dkjonas/WildWillyR5Hardware/README.md

Schematic and board layout for the R5 version of my robot.

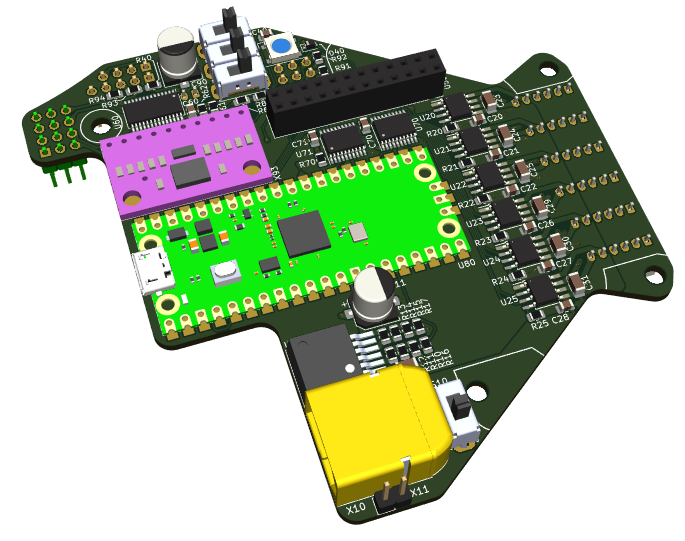
[picture p1: render/front.png]
Render of front

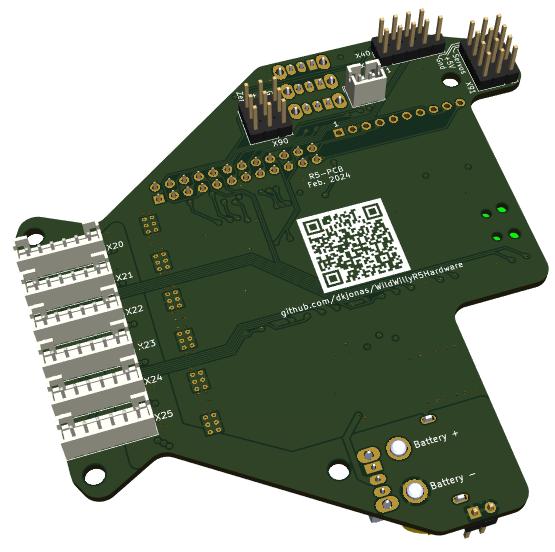
[picture p2: render/back.png]
Render of back
