dkjonas/WildWillyR5Hardware/r5.kicad_pcb

## KiCad design r5.kicad_pcb (2024-02-03)

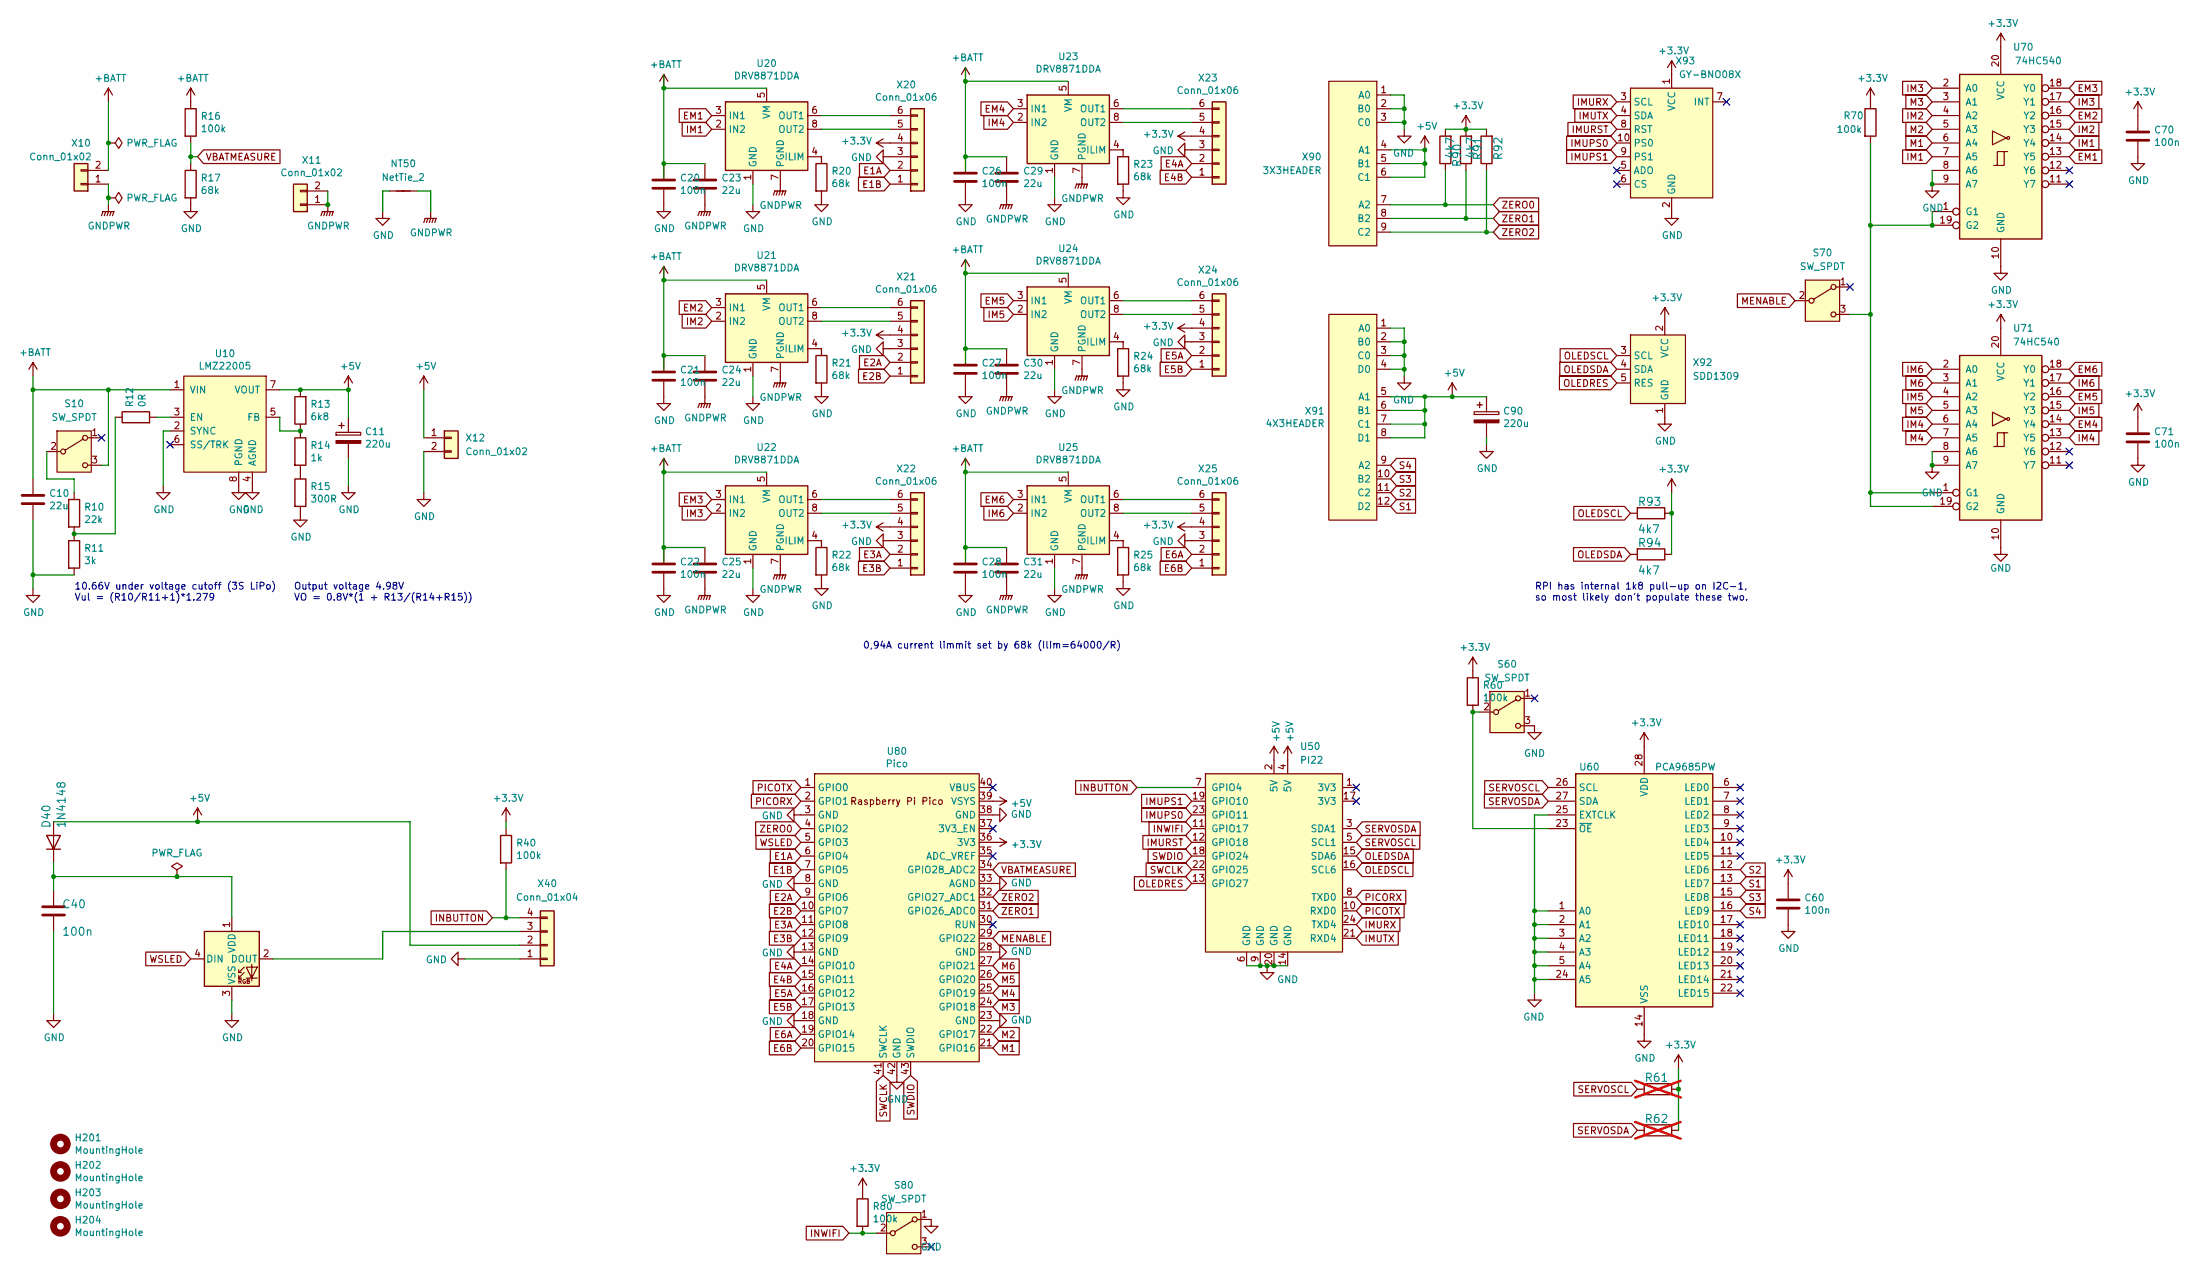
[picture p3: schematic r5.kicad_sch]

Parts:
C10, C23, C24, C25, C29, C30, C31: 22u; C_1206_3216Metric; LCSC Part # C12891
C11, C90: 220u; CP_Elec_6.3x7.7; LCSC Part # C970695
C20, C21, C22, C26, C27, C28, C40, C60, C70, C71: 100n; C_0805_2012Metric; LCSC Part # C49678
D40: 1N4148; D_SOD-323; LCSC Part # C2128
D41: WS2812B5050; LED_WS2812B_PLCC4_5.0x5.0mm_P3.2mm
H201, H202, H203, H204: MountingHole; MountingHole_3.2mm_M3
NT50: NetTie_2; NetTie-2_SMD_Pad2.0mm
R10: 22k; R_0805_2012Metric; LCSC Part # C17560
R11: 3k; R_0805_2012Metric; LCSC Part # C17661
R12: 0R; R_0805_2012Metric; LCSC Part # C17477
R13: 6k8; R_0805_2012Metric; LCSC Part # C17772
R14: 1k; R_0805_2012Metric; LCSC Part # C17513
R15: 300R; R_0805_2012Metric; LCSC Part # C17617
R16, R40, R60, R70, R80: 100k; R_0805_2012Metric; LCSC Part # C149504
R17, R20, R21, R22, R23, R24, R25: 68k; R_0805_2012Metric; LCSC Part # C17801
R61, R62: R_0805_2012Metric; not fitted
R90, R91, R92, R93, R94: 4k7; R_0805_2012Metric; LCSC Part # C17673
S10, S60, S70, S80: SW_SPDT; SW_Slide_1P2T_CK_OS102011MS2Q
U10: LMZ22005; 7TO-PMOD; LCSC Part # C2865843
U20, U21, U22, U23, U24, U25: DRV8871DDA; Texas_HTSOP-8-1EP_3.9x4.9mm_P1.27mm_EP2.95x4.9mm_Mask2.4x3.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; JLCPCB Rotation Offset -90
U50: PI22; PinSocket_2x12_P2.54mm_Vertical
U60: PCA9685PW; TSSOP-28_4.4x9.7mm_P0.65mm; LCSC Part # C2678753
U70, U71: 74HC540; TSSOP-20_4.4x6.5mm_P0.65mm; LCSC Part # C2682166
U80: Pico; RaspberryPiPico_SMD
X10: Conn_01x02; AMASS_XT60PW-M
X11: Conn_01x02; PinHeader_1x02_P2.54mm_Vertical
X12: Conn_01x02; JST_PH_B2B-PH-K_1x02_P2.00mm_Vertical
X20, X21, X22, X23, X24, X25: Conn_01x06; JST_PH_B6B-PH-K_1x06_P2.00mm_Vertical
X40: Conn_01x04; PinHeader_1x04_P2.54mm_Vertical
X90: 3X3HEADER; PinHeader_3x03_P2.54mm_Vertical
X91: 4X3HEADER; PinHeader_3x04_P2.54mm_Vertical
X92: SDD1309; PinHeader_1x05_P2.54mm_Vertical
X93: GY-BNO08X

Connections:
+3.3V: C60.1, C70.1, C71.1, R40.1, R60.1, R61.1, R62.1, R70.1, R80.1, R90.2, R91.2, R92.2, R93.1, R94.1, U60.28 (VDD), U70.20 (VCC), U71.20 (VCC), U80.36 (3V3), X20.4, X21.4, X22.4, X23.4, X24.4, X25.4, X92.2 (VCC), X93.1 (VCC)
+5V: C11.1, C90.1, D40.2 (A), R13.2, U10.7 (VOUT), U50.2 (5V), U50.4 (5V), U80.39 (VSYS), X12.1, X40.2, X90.4 (A1), X90.5 (B1), X90.6 (C1), X91.5 (A1), X91.6 (B1), X91.7 (C1), X91.8 (D1)
+BATT: C10.1, C20.1, C21.1, C22.1, C23.1, C24.1, C25.1, C26.1, C27.1, C28.1, C29.1, C30.1, C31.1, R16.1, S10.3 (C), U10.1 (VIN), U20.5 (VM), U21.5 (VM), U22.5 (VM), U23.5 (VM), U24.5 (VM), U25.5 (VM), X10.2
E1A: U80.6 (GPIO4), X20.2
E1B: U80.7 (GPIO5), X20.1
E2A: U80.9 (GPIO6), X21.2
E2B: U80.10 (GPIO7), X21.1
E3A: U80.11 (GPIO8), X22.2
E3B: U80.12 (GPIO9), X22.1
E4A: U80.14 (GPIO10), X23.2
E4B: U80.15 (GPIO11), X23.1
E5A: U80.16 (GPIO12), X24.2
E5B: U80.17 (GPIO13), X24.1
E6A: U80.19 (GPIO14), X25.2
E6B: U80.20 (GPIO15), X25.1
EM1: U20.3 (IN1), U70.13 (Y5)
EM2: U21.3 (IN1), U70.16 (Y2)
EM3: U22.3 (IN1), U70.18 (Y0)
EM4: U23.3 (IN1), U71.14 (Y4)
EM5: U24.3 (IN1), U71.16 (Y2)
EM6: U25.3 (IN1), U71.18 (Y0)
GND: C10.2, C11.2, C20.2, C21.2, C22.2, C26.2, C27.2, C28.2, C40.2, C60.2, C70.2, C71.2, C90.2, D41.3 (VSS), NT50.1, R11.2, R15.2, R17.2, R20.2, R21.2, R22.2, R23.2, R24.2, R25.2, S60.3 (C), S80.1 (A), U10.2 (SYNC), U10.4 (AGND), U10.8 (PGND), U20.1 (GND), U20.9 (GND), U21.1 (GND), U21.9 (GND), U22.1 (GND), U22.9 (GND), U23.1 (GND), U23.9 (GND), U24.1 (GND), U24.9 (GND), U25.1 (GND), U25.9 (GND), U50.6 (GND), U50.9 (GND), U50.14 (GND), U50.20 (GND), U60.1 (A0), U60.2 (A1), U60.3 (A2), U60.4 (A3), U60.5 (A4), U60.14 (VSS), U60.24 (A5), U60.25 (EXTCLK), U70.8 (A6), U70.9 (A7), U70.10 (GND), U71.8 (A6), U71.9 (A7), U71.10 (GND), U80.3 (GND), U80.8 (GND), U80.13 (GND), U80.18 (GND), U80.23 (GND), U80.28 (GND), U80.33 (AGND), U80.38 (GND), U80.42 (GND), X12.2, X20.3, X21.3, X22.3, X23.3, X24.3, X25.3, X40.1, X90.1 (A0), X90.2 (B0), X90.3 (C0), X91.1 (A0), X91.2 (B0), X91.3 (C0), X91.4 (D0), X92.1 (GND), X93.2 (GND)
GNDPWR: C23.2, C24.2, C25.2, C29.2, C30.2, C31.2, NT50.2, U20.7 (PGND), U21.7 (PGND), U22.7 (PGND), U23.7 (PGND), U24.7 (PGND), U25.7 (PGND), X10.1, X11.1, X11.2
IM1: U20.2 (IN2), U70.7 (A5), U70.14 (Y4)
IM2: U21.2 (IN2), U70.4 (A2), U70.15 (Y3)
IM3: U22.2 (IN2), U70.2 (A0), U70.17 (Y1)
IM4: U23.2 (IN2), U71.6 (A4), U71.13 (Y5)
IM5: U24.2 (IN2), U71.4 (A2), U71.15 (Y3)
IM6: U25.2 (IN2), U71.2 (A0), U71.17 (Y1)
IMUPS0: U50.23 (GPIO11), X93.10 (PS0)
IMUPS1: U50.19 (GPIO10), X93.9 (PS1)
IMURST: U50.12 (GPIO18), X93.8 (RST)
IMURX: U50.24 (TXD4), X93.3 (SCL)
IMUTX: U50.21 (RXD4), X93.4 (SDA)
INBUTTON: R40.2, U50.7 (GPIO4), X40.4
INWIFI: R80.2, S80.2 (B), U50.11 (GPIO17)
M1: U70.6 (A4), U80.21 (GPIO16)
M2: U70.5 (A3), U80.22 (GPIO17)
M3: U70.3 (A1), U80.24 (GPIO18)
M4: U71.7 (A5), U80.25 (GPIO19)
M5: U71.5 (A3), U80.26 (GPIO20)
M6: U71.3 (A1), U80.27 (GPIO21)
MENABLE: S70.2 (B), U80.29 (GPIO22)
unnamed: C40.1, D40.1 (K), D41.1 (VDD)
unnamed: D41.2 (DOUT), X40.3
unnamed: R10.2, R11.1, R12.1
unnamed: R14.2, R15.1
unnamed: R10.1, S10.2 (B)
unnamed: R60.2, S60.2 (B), U60.23 (~OE)
unnamed: R70.2, S70.3 (C), U70.1 (G1), U70.19 (G2), U71.1 (G1), U71.19 (G2)
unnamed: R12.2, U10.3 (EN)
unnamed: R13.1, R14.1, U10.5 (FB)
unnamed: R20.1, U20.4 (ILIM)
unnamed: U20.6 (OUT1), X20.6
unnamed: U20.8 (OUT2), X20.5
unnamed: R21.1, U21.4 (ILIM)
unnamed: U21.6 (OUT1), X21.6
unnamed: U21.8 (OUT2), X21.5
unnamed: R22.1, U22.4 (ILIM)
unnamed: U22.6 (OUT1), X22.6
unnamed: U22.8 (OUT2), X22.5
unnamed: R23.1, U23.4 (ILIM)
unnamed: U23.6 (OUT1), X23.6
unnamed: U23.8 (OUT2), X23.5
unnamed: R24.1, U24.4 (ILIM)
unnamed: U24.6 (OUT1), X24.6
unnamed: U24.8 (OUT2), X24.5
unnamed: R25.1, U25.4 (ILIM)
unnamed: U25.6 (OUT1), X25.6
unnamed: U25.8 (OUT2), X25.5
OLEDRES: U50.13 (GPIO27), X92.5 (RES)
OLEDSCL: R93.2, U50.16 (SCL6), X92.3 (SCL)
OLEDSDA: R94.2, U50.15 (SDA6), X92.4 (SDA)
PICORX: U50.8 (TXD0), U80.2 (GPIO1)
PICOTX: U50.10 (RXD0), U80.1 (GPIO0)
S1: U60.13 (LED7), X91.12 (D2)
S2: U60.12 (LED6), X91.11 (C2)
S3: U60.15 (LED8), X91.10 (B2)
S4: U60.16 (LED9), X91.9 (A2)
SERVOSCL: R61.2, U50.5 (SCL1), U60.26 (SCL)
SERVOSDA: R62.2, U50.3 (SDA1), U60.27 (SDA)
SWCLK: U50.22 (GPIO25), U80.41 (SWCLK)
SWDIO: U50.18 (GPIO24), U80.43 (SWDIO)
VBATMEASURE: R16.2, R17.1, U80.34 (GPIO28_ADC2)
WSLED: D41.4 (DIN), U80.5 (GPIO3)
ZERO0: R90.1, U80.4 (GPIO2), X90.7 (A2)
ZERO1: R91.1, U80.31 (GPIO26_ADC0), X90.8 (B2)
ZERO2: R92.1, U80.32 (GPIO27_ADC1), X90.9 (C2)

Notes on the sheet:
0,94A current limmit set by 68k (Ilim=64000/R)
Output voltage 4.98V VO = 0.8V*(1 + R13/(R14+R15))
10.66V under voltage cutoff (3S LiPo) Vul = (R10/R11+1)*1.279
RPI has internal 1k8 pull-up on I2C-1, so most likely don't populate these two.

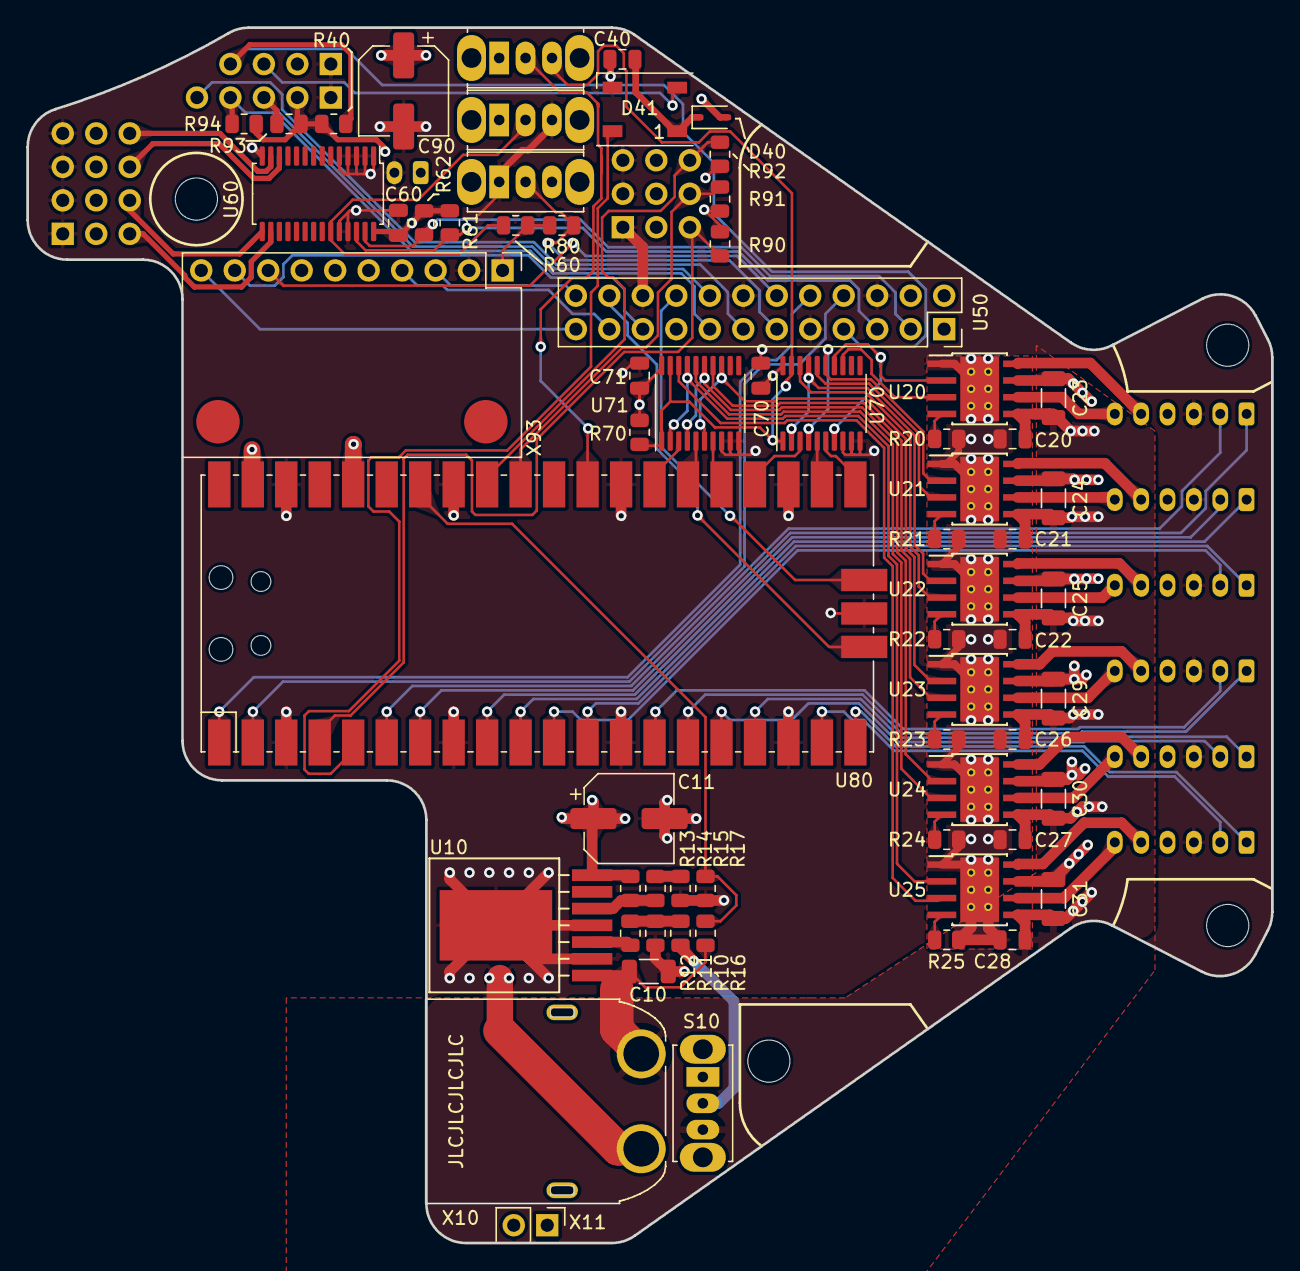
[picture p4: board r5.kicad_pcb from above]

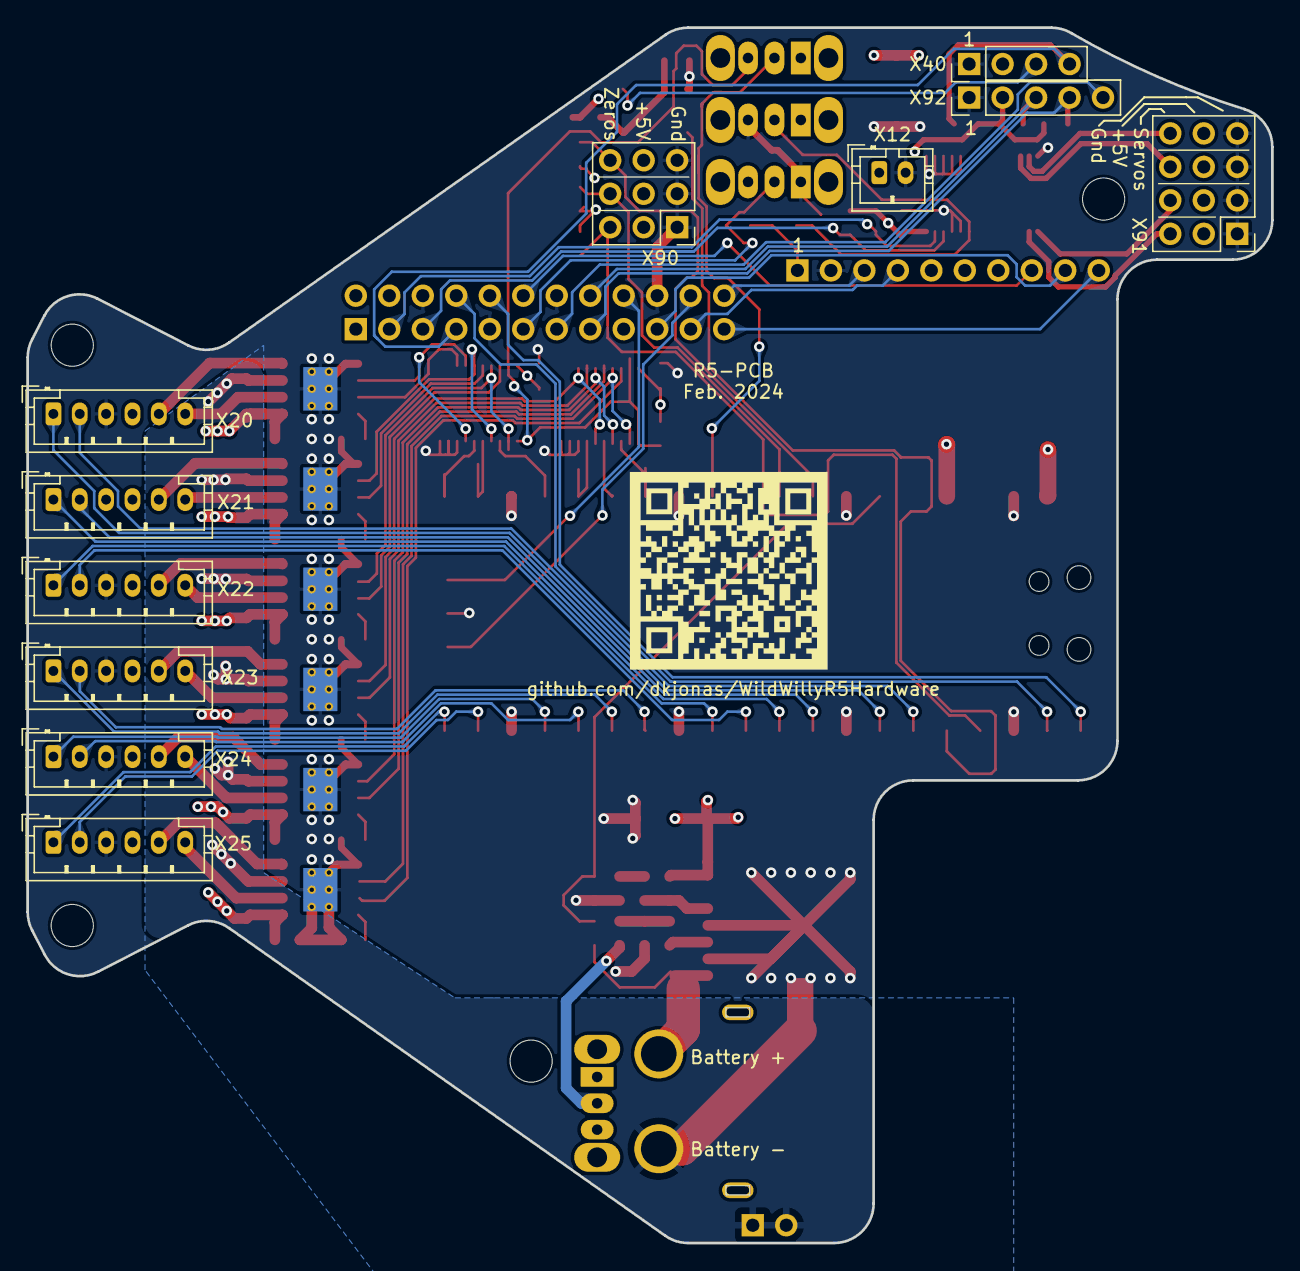
[picture p5: board r5.kicad_pcb from below]

Board: 4 copper layers, 94.4 x 92.2 mm, 81 parts (11 on the bottom side), 88 nets.
