dkjonas/WildWillyR5Hardware/(commit log)

2024-01-24 Initial import of R5
    [r5.kicad_pcb, r5.kicad_sch]
2024-01-25 Add JLCPCB design rules
    [r5.kicad_pcb]
2024-01-29 component placement
    [r5.kicad_pcb, r5.kicad_sch]
2024-01-29 start routing
    [r5.kicad_pcb, r5.kicad_sch]
2024-01-30 use 2 inverters
    [r5.kicad_pcb, r5.kicad_sch]
2024-01-30 routing continued
    [r5.kicad_pcb, r5.kicad_sch]
2024-01-31 routing done
    [r5.kicad_pcb, r5.kicad_sch]
2024-01-31 remove some DRC
    [r5.kicad_pcb]
2024-02-01 Silk cleanup
    [r5.kicad_pcb, r5.kicad_sch]
2024-02-03 board done
    [r5.kicad_pcb, r5.kicad_sch]
2024-02-03 Production files 2024-02-03
    [bom.csv, designators.csv, positions.csv, r5.kicad_pcb]
2024-02-06 minor schematic cleanup
    [r5.kicad_sch]
